TFT-Ben/Lancer/ECAD_r2_sch.PDF

## AVR1_AVI

C1

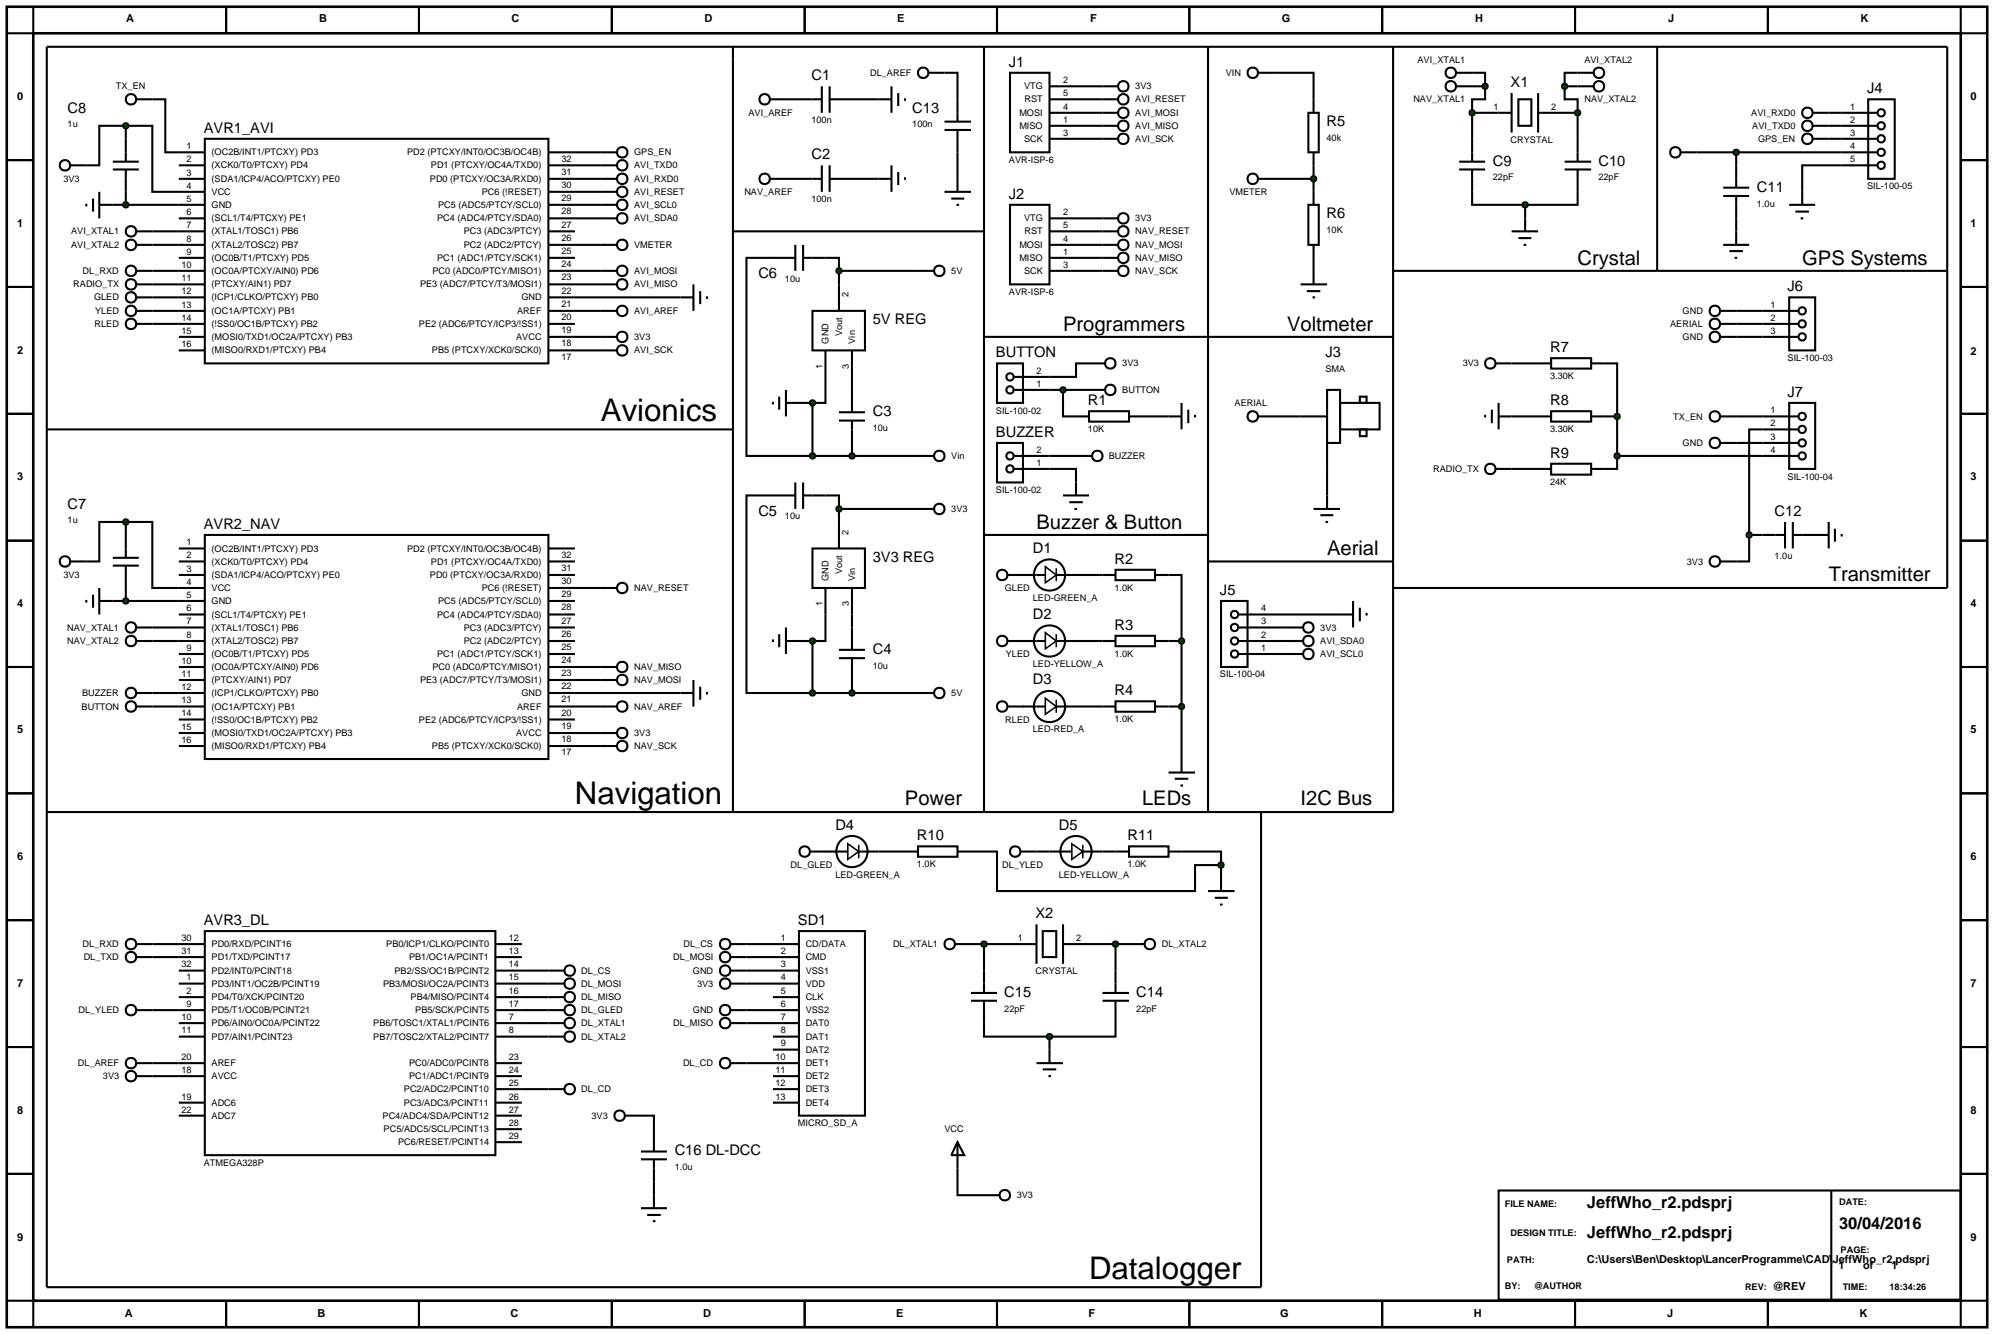
[picture p34: page 1]

BUTTON 3V3 2 1 BUTTON R1 BUZZER 2 BUZZER 1 Buzzer & Button | J3 SMA AERIAL Aerial

D1 R2 GLED 1.0K D2 R3 LEDs
